airsoftak25/RoboCrew/README.md

# RoboCrew - Prosek

# Table of content
* NeoSumec
* LF-Neo - *doesnt exist yet*
* LF-Pendolino-MK1

# Description
This repo contains link to all other repo of ours projects  

# NeoSumec
An autonomous robot that competes in Mini-Sumo competitions, made by a team of students from **SPŠ-Prosek**.
| Part | Repo link | Description |
|:-:|:-:|:-|
| Software | [Open](https://github.com/kubikaugustyn/NeoSumec-MiniSumo-FW) | Contains our code for project |
| Hardware | [Open](https://github.com/airsoftak25/NeoSumec-MiniSumo-HW) | Contains our elektro stuff for project |
| Mechanical | [Open](https://github.com/airsoftak25/NeoSumec-MiniSumo-MECH) | Contains our mechanical part of project |

## Contributors
Peoples that work on the some part of our project **NeoSumec**
| Name | On what part they work |
|:-:|:-|
| Vadim Sobčuk (airsoftak25)| Head of HW and Mech part|
| Jakub Augustýn | Head of coding |

# LF-Neo
An autonomous robot designed to complete the track in the shortest possible time. Made by a team of students from **SPŠ-Prosek**.
**Doesnt exist  yet**
| Part | Repo link | Description |
|:-:|:-:|:-|
| Software | [Open](Doesnt-exist-yet) | Contains our code for project |
| Hardware | [Open](Doesnt-exist-yet) | Contains our elektro stuff for project |
| Mechanical | [Open](Doesnt-exist-yet) | Contains our mechanical part of project |

## Contributors
Peoples that work on the some part of our project **NeoSumec**
| Name | On what part they work |
|:-:|:-|
| Vadim Sobčuk | Who knows |

# Other project

## LF-Pendolino-MK1
An autonomus robot designed to complete the track in the shortest possible time. Maded by [**Luboš Stránský**](https://github.com/lubosstransky2008)
* [**Repo link**](https://github.com/lubosstransky2008/LF-Pendolino_MK1) *(this is his first solo project and we are proud of him)*
