airsoftak25/RoboCrew/RoboClash/LF-časomírá/HW/LF_LAP_TIMER.csv.xlsx

Reference | Qty | Value | Footprint | Link
A1 | 1 | Arduino_UNO_R3 | Module:Arduino_UNO_R3 | Link (https://dratek.cz/arduino-platforma/974-eses-klon-arduino-uno-r3-precise.html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)
C1 | 1 | 100nF | Capacitor_THT:C_Disc_D6.0mm_W2.5mm_P5.00mm
J1 | 1 | SENSOR TERMINAL | TerminalBlock:TerminalBlock_MaiXu_MX126-5.0-02P_1x02_P5.00mm | Link (https://www.gme.cz/v/1497255/kls-300-500-02p-2-sc-svorkovnice-2pol-roztec-5mm-16a-250v-vstup-90-sroub)
J2 | 1 | SENSOR TERMINAL | TerminalBlock:TerminalBlock_MaiXu_MX126-5.0-05P_1x05_P5.00mm | Link (https://www.gme.cz/v/1497255/kls-300-500-02p-2-sc-svorkovnice-2pol-roztec-5mm-16a-250v-vstup-90-sroub)
J3 | 1 | LCD TERMINAL | TerminalBlock:TerminalBlock_MaiXu_MX126-5.0-05P_1x05_P5.00mm | Link (https://dratek.cz/arduino-platforma/1570-iic-i2c-display-lcd-1602-16x2-znaku-lcd-modul-modry.html)
K1 | 1 | E3JK-5DM1-5L |  | Link (https://www.hadex.cz/p/t532-infracervena-zavora-e3jk-5dm1-5l-opticka-zavora-2)
R1,R2 | 2 | 0R | Resistor_THT:R_Axial_DIN0207_L6.3mm_D2.5mm_P10.16mm_Horizontal
R4,R5,R6,R9,R10 | 5 | 10K | Resistor_THT:R_Axial_DIN0207_L6.3mm_D2.5mm_P10.16mm_Horizontal
R7 | 1 | 1k | Resistor_THT:R_Axial_DIN0207_L6.3mm_D2.5mm_P10.16mm_Horizontal
R8 | 1 | 10k | Resistor_THT:R_Axial_DIN0207_L6.3mm_D2.5mm_P10.16mm_Horizontal
SW1 | 1 | ARM | TerminalBlock:TerminalBlock_MaiXu_MX126-5.0-02P_1x02_P5.00mm | Link (https://www.gme.cz/v/1498072/pbs-12b-g-tlacitko-do-panelu-1-pol-offon)
SW2 | 1 | STOP | TerminalBlock:TerminalBlock_MaiXu_MX126-5.0-02P_1x02_P5.00mm | Link (https://www.gme.cz/v/1497195/pbs-12b-r-tlacitko-do-panelu-1-pol-offon)
SW3 | 1 | RESTART | TerminalBlock:TerminalBlock_MaiXu_MX126-5.0-02P_1x02_P5.00mm | Link (https://www.gme.cz/v/1498070/pbs-12b-bl-tlacitko-do-panelu-1-pol-offon)
