airsoftak25/RoboCrew/RoboClash/LF-časomírá/MECH/LineFollower_Gate/Gate/Leg.dxf

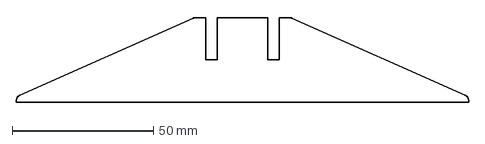
[picture p1: CAD file, 2026-03-25]
RoboClash/LF-časomírá/MECH/LineFollower_Gate/Gate/Leg.dxf
160.0 x 30.0 mm
