airsoftak25/RoboCrew/RoboClash/LF-časomírá/MECH/LineFollower_Gate/GateLessMaterial/GateBrigeSideLessMaterial.dxf

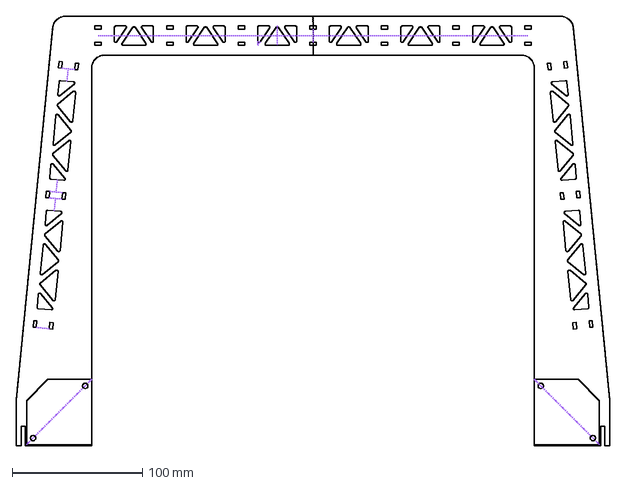
[picture p2: CAD file, 2026-04-06]
RoboClash/LF-časomírá/MECH/LineFollower_Gate/GateLessMaterial/GateBrigeSideLessMaterial.dxf
456.0 x 330.0 mm
