airsoftak25/RoboCrew/RoboClash/LF-časomírá/MECH/LineFollower_Gate/LF_Gate.dxf

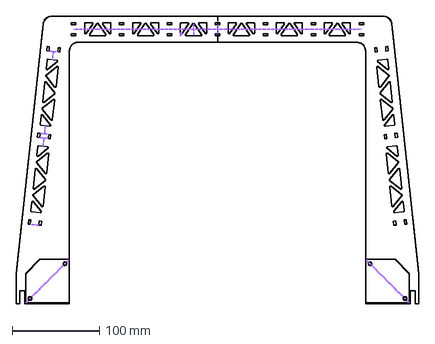
[picture p3: CAD file, 2026-04-11]
RoboClash/LF-časomírá/MECH/LineFollower_Gate/LF_Gate.dxf
462.0 x 330.0 mm
