airsoftak25/RoboCrew/RoboClash/LF-časomírá/MECH/LineFollower_Gate/Gate/Spacer.dxf

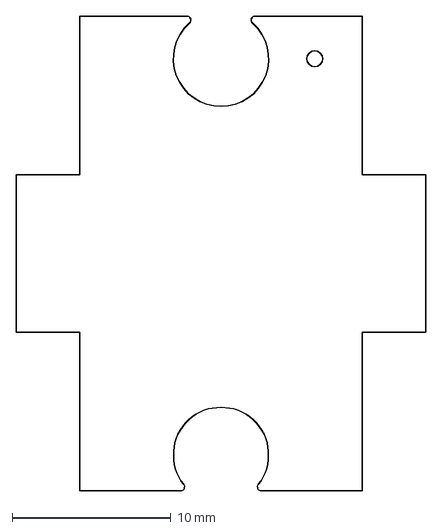
[picture p4: CAD file, 2026-03-25]
RoboClash/LF-časomírá/MECH/LineFollower_Gate/Gate/Spacer.dxf
25.8 x 29.9 mm
