airsoftak25/RoboCrew/RoboClash/LF-časomírá/MECH/LineFollower_Gate/GateLessMaterial/LegLessMaterial.dxf

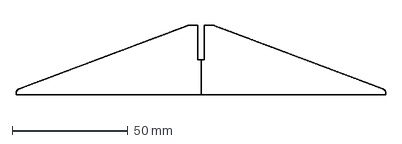
[picture p5: CAD file, 2026-04-06]
RoboClash/LF-časomírá/MECH/LineFollower_Gate/GateLessMaterial/LegLessMaterial.dxf
160.0 x 30.0 mm
