airsoftak25/RoboCrew/RoboClash/LF-časomírá/MECH/LineFollower_Gate/leg.dxf

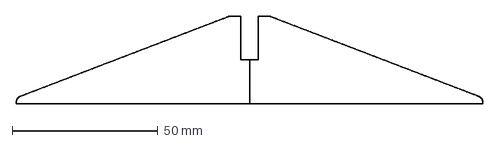
[picture p6: CAD file, 2026-04-11]
RoboClash/LF-časomírá/MECH/LineFollower_Gate/leg.dxf
160.0 x 30.0 mm
