airsoftak25/RoboCrew/RoboClash/LF-časomírá/MECH/LineFollower_Gate/Gate/GateBrigeSide.dxf

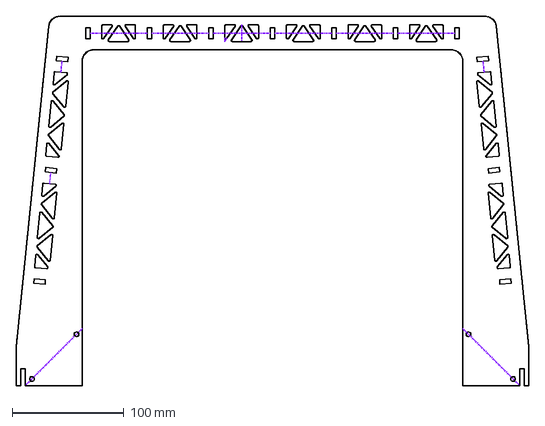
[picture p7: CAD file, 2026-03-25]
RoboClash/LF-časomírá/MECH/LineFollower_Gate/Gate/GateBrigeSide.dxf
458.0 x 330.0 mm
