airsoftak25/RoboCrew/RoboClash/LF-časomírá/MECH/_V1/LineFolloweLapTimer_PCB-Housing/FL-LapTimer-noha.stl

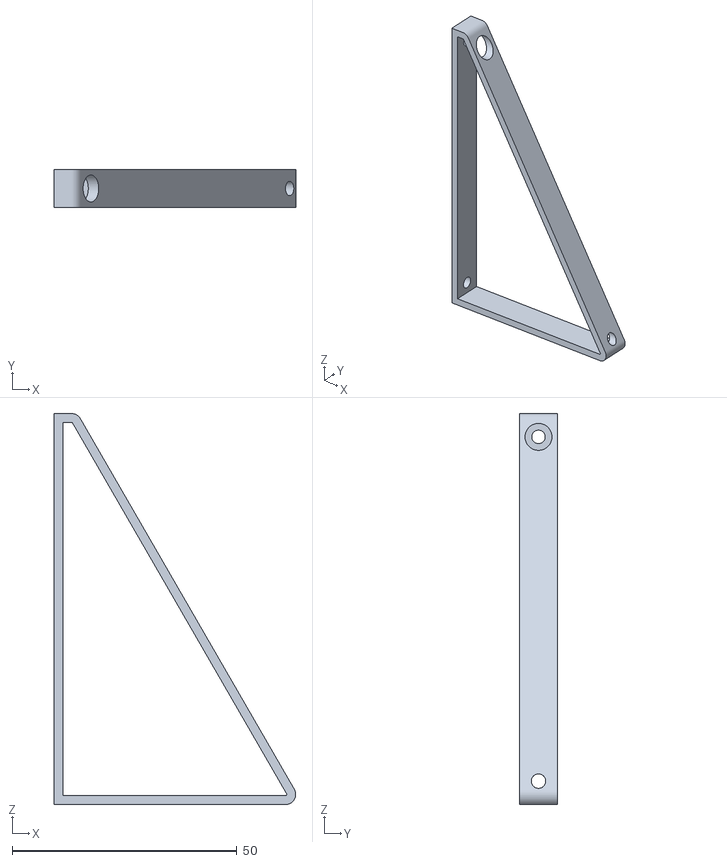
[picture p8: CAD file, 2026-03-25, an earlier design]
RoboClash/LF-časomírá/MECH/_V1/LineFolloweLapTimer_PCB-Housing/FL-LapTimer-noha.stl
53.7 x 8.50 x 87.0
