airsoftak25/RoboCrew/RoboClash/LF-časomírá/MECH/_V1/LineFolloweLapTimer_PCB-Housing/PCB-HousingTop.stl

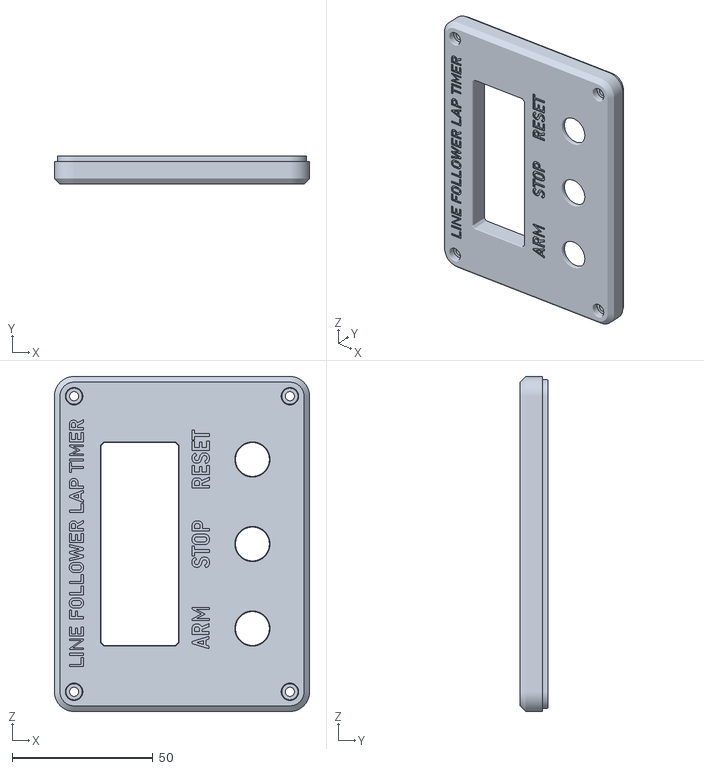
[picture p9: CAD file, 2026-03-25, an earlier design]
RoboClash/LF-časomírá/MECH/_V1/LineFolloweLapTimer_PCB-Housing/PCB-HousingTop.stl
90.6 x 10.0 x 118.9
