airsoftak25/RoboCrew/RoboClash/LF-časomírá/MECH/_V1/LineFolloweLapTimer_PCB-Housing/PCB-HousingBottom.stl

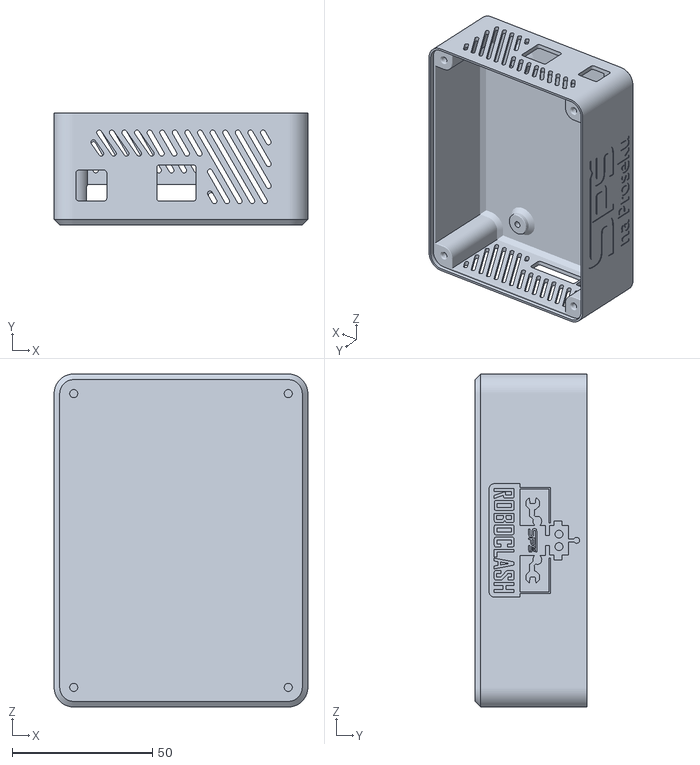
[picture p10: CAD file, 2026-03-25, an earlier design]
RoboClash/LF-časomírá/MECH/_V1/LineFolloweLapTimer_PCB-Housing/PCB-HousingBottom.stl
90.6 x 40.0 x 118.9
