airsoftak25/RoboCrew/(list of files, cad)

Other CAD files:
RoboClash/LF-časomírá/MECH/LineFollower_Gate/Gate/GateAssembly.iam
RoboClash/LF-časomírá/MECH/LineFollower_Gate/Gate/GateBrigeSide.ipt
RoboClash/LF-časomírá/MECH/LineFollower_Gate/Gate/Leg.ipt
RoboClash/LF-časomírá/MECH/LineFollower_Gate/Gate/OldVersions/GateAssembly.0001.iam
RoboClash/LF-časomírá/MECH/LineFollower_Gate/Gate/OldVersions/GateBrigeSide.0004.ipt
RoboClash/LF-časomírá/MECH/LineFollower_Gate/Gate/OldVersions/Spacer.0003.ipt
RoboClash/LF-časomírá/MECH/LineFollower_Gate/Gate/Sensor.ipt
RoboClash/LF-časomírá/MECH/LineFollower_Gate/Gate/Spacer.ipt
RoboClash/LF-časomírá/MECH/LineFollower_Gate/GateLessMaterial/GateBrigeSideLessMaterial.ipt
RoboClash/LF-časomírá/MECH/LineFollower_Gate/GateLessMaterial/GateLessMaterialAssembly.iam
RoboClash/LF-časomírá/MECH/LineFollower_Gate/GateLessMaterial/LegLessMaterial.ipt
RoboClash/LF-časomírá/MECH/LineFollower_Gate/GateLessMaterial/OldVersions/GateBrigeSide.0003.ipt
RoboClash/LF-časomírá/MECH/LineFollower_Gate/GateLessMaterial/OldVersions/GateLessMaterialAssembly.0001.iam
RoboClash/LF-časomírá/MECH/LineFollower_Gate/GateLessMaterial/OldVersions/Leg.0001.ipt
RoboClash/LF-časomírá/MECH/LineFollower_Gate/GateLessMaterial/Sensor.ipt
RoboClash/LF-časomírá/MECH/_V1/LineFolloweLapTimer_PCB-Housing/FL-LapTimer-Foot.ipt
RoboClash/LF-časomírá/MECH/_V1/LineFolloweLapTimer_PCB-Housing/LF_LAP_TIMER/10 PORT HEADER.ipt
RoboClash/LF-časomírá/MECH/_V1/LineFolloweLapTimer_PCB-Housing/LF_LAP_TIMER/102 RESISTOR PACK.ipt
RoboClash/LF-časomírá/MECH/_V1/LineFolloweLapTimer_PCB-Housing/LF_LAP_TIMER/103 RESISTOR PACK.ipt
RoboClash/LF-časomírá/MECH/_V1/LineFolloweLapTimer_PCB-Housing/LF_LAP_TIMER/16mhz crystal - measured.ipt
RoboClash/LF-časomírá/MECH/_V1/LineFolloweLapTimer_PCB-Housing/LF_LAP_TIMER/220 RESISTOR PACK.ipt
RoboClash/LF-časomírá/MECH/_V1/LineFolloweLapTimer_PCB-Housing/LF_LAP_TIMER/2pin_header__02.ipt
RoboClash/LF-časomírá/MECH/_V1/LineFolloweLapTimer_PCB-Housing/LF_LAP_TIMER/47uf CAP Dcase.ipt
RoboClash/LF-časomírá/MECH/_V1/LineFolloweLapTimer_PCB-Housing/LF_LAP_TIMER/6 PORT HEADER.ipt
RoboClash/LF-časomírá/MECH/_V1/LineFolloweLapTimer_PCB-Housing/LF_LAP_TIMER/603 cap on pad.ipt
RoboClash/LF-časomírá/MECH/_V1/LineFolloweLapTimer_PCB-Housing/LF_LAP_TIMER/603 resistor.ipt
RoboClash/LF-časomírá/MECH/_V1/LineFolloweLapTimer_PCB-Housing/LF_LAP_TIMER/8 PORT HEADER.ipt
RoboClash/LF-časomírá/MECH/_V1/LineFolloweLapTimer_PCB-Housing/LF_LAP_TIMER/ATMEL328P.ipt
RoboClash/LF-časomírá/MECH/_V1/LineFolloweLapTimer_PCB-Housing/LF_LAP_TIMER/C_Disc_D6.0mm_W2.5mm_P5.00mm.ipt
RoboClash/LF-časomírá/MECH/_V1/LineFolloweLapTimer_PCB-Housing/LF_LAP_TIMER/LCD.iam
RoboClash/LF-časomírá/MECH/_V1/LineFolloweLapTimer_PCB-Housing/LF_LAP_TIMER/LF_LAP_TIMER.iam
RoboClash/LF-časomírá/MECH/_V1/LineFolloweLapTimer_PCB-Housing/LF_LAP_TIMER/LF_LAP_TIMER_PCB.ipt
RoboClash/LF-časomírá/MECH/_V1/LineFolloweLapTimer_PCB-Housing/LF_LAP_TIMER/LF_LAP_TIMER_silkscreen.ipt
RoboClash/LF-časomírá/MECH/_V1/LineFolloweLapTimer_PCB-Housing/LF_LAP_TIMER/MLC0603.ipt
RoboClash/LF-časomírá/MECH/_V1/LineFolloweLapTimer_PCB-Housing/LF_LAP_TIMER/PADS001.ipt
RoboClash/LF-časomírá/MECH/_V1/LineFolloweLapTimer_PCB-Housing/LF_LAP_TIMER/PCB-HousingBottom.ipt
RoboClash/LF-časomírá/MECH/_V1/LineFolloweLapTimer_PCB-Housing/LF_LAP_TIMER/PCB-HousingTop.ipt
RoboClash/LF-časomírá/MECH/_V1/LineFolloweLapTimer_PCB-Housing/LF_LAP_TIMER/RESET BUTTON.iam
RoboClash/LF-časomírá/MECH/_V1/LineFolloweLapTimer_PCB-Housing/LF_LAP_TIMER/RESET CORE.ipt
RoboClash/LF-časomírá/MECH/_V1/LineFolloweLapTimer_PCB-Housing/LF_LAP_TIMER/RESET.ipt
RoboClash/LF-časomírá/MECH/_V1/LineFolloweLapTimer_PCB-Housing/LF_LAP_TIMER/R_Axial_DIN0207_L6.3mm_D2.5mm_P10.16mm_Horizontal.ipt
RoboClash/LF-časomírá/MECH/_V1/LineFolloweLapTimer_PCB-Housing/LF_LAP_TIMER/USB SHELL.ipt
RoboClash/LF-časomírá/MECH/_V1/LineFolloweLapTimer_PCB-Housing/LF_LAP_TIMER/USB core.ipt
RoboClash/LF-časomírá/MECH/_V1/LineFolloweLapTimer_PCB-Housing/LF_LAP_TIMER/USB type b.SLDPRT.iam
RoboClash/LF-časomírá/MECH/_V1/LineFolloweLapTimer_PCB-Housing/LF_LAP_TIMER/_PCB-HousingAssembly.iam
RoboClash/LF-časomírá/MECH/_V1/LineFolloweLapTimer_PCB-Housing/LF_LAP_TIMER/arduino uno.iam
RoboClash/LF-časomírá/MECH/_V1/LineFolloweLapTimer_PCB-Housing/LF_LAP_TIMER/atmega16u2.ipt
RoboClash/LF-časomírá/MECH/_V1/LineFolloweLapTimer_PCB-Housing/LF_LAP_TIMER/blm21.ipt
RoboClash/LF-časomírá/MECH/_V1/LineFolloweLapTimer_PCB-Housing/LF_LAP_TIMER/cd1206 diode.ipt
RoboClash/LF-časomírá/MECH/_V1/LineFolloweLapTimer_PCB-Housing/LF_LAP_TIMER/crystal.ipt
RoboClash/LF-časomírá/MECH/_V1/LineFolloweLapTimer_PCB-Housing/LF_LAP_TIMER/dip socket pin.ipt
RoboClash/LF-časomírá/MECH/_V1/LineFolloweLapTimer_PCB-Housing/LF_LAP_TIMER/dip28.iam
RoboClash/LF-časomírá/MECH/_V1/LineFolloweLapTimer_PCB-Housing/LF_LAP_TIMER/dip28.ipt
RoboClash/LF-časomírá/MECH/_V1/LineFolloweLapTimer_PCB-Housing/LF_LAP_TIMER/led.ipt
RoboClash/LF-časomírá/MECH/_V1/LineFolloweLapTimer_PCB-Housing/LF_LAP_TIMER/lmv358.ipt
RoboClash/LF-časomírá/MECH/_V1/LineFolloweLapTimer_PCB-Housing/LF_LAP_TIMER/lp2985dgkr.ipt
RoboClash/LF-časomírá/MECH/_V1/LineFolloweLapTimer_PCB-Housing/LF_LAP_TIMER/m7 diode.ipt
RoboClash/LF-časomírá/MECH/_V1/LineFolloweLapTimer_PCB-Housing/LF_LAP_TIMER/mf-msmf050-2.ipt
RoboClash/LF-časomírá/MECH/_V1/LineFolloweLapTimer_PCB-Housing/LF_LAP_TIMER/nano - reg.ipt
RoboClash/LF-časomírá/MECH/_V1/LineFolloweLapTimer_PCB-Housing/LF_LAP_TIMER/power jack.ipt
RoboClash/LF-časomírá/MECH/_V1/LineFolloweLapTimer_PCB-Housing/LF_LAP_TIMER/ssot3.ipt
RoboClash/LF-časomírá/MECH/_V1/LineFolloweLapTimer_PCB-Housing/LF_LAP_TIMER/unoboard blue.ipt
RoboClash/LF-časomírá/MECH/_V1/LineFolloweLapTimer_PCB-Housing/LF_LAP_TIMER/usb btm contact.ipt
RoboClash/LF-časomírá/MECH/_V1/LineFolloweLapTimer_PCB-Housing/LF_LAP_TIMER/usb top contact.ipt
RoboClash/LF-časomírá/MECH/_V1/LineFolloweLapTimer_PCB-Housing/OldVersions/LF_LAP_TIMER.0001.iam
RoboClash/LF-časomírá/MECH/_V1/LineFolloweLapTimer_PCB-Housing/OldVersions/PCB-HousingAssembly.0005.iam
RoboClash/LF-časomírá/MECH/_V1/LineFolloweLapTimer_PCB-Housing/OldVersions/PCB-HousingBottom.0011.ipt
RoboClash/LF-časomírá/MECH/_V1/LineFolloweLapTimer_PCB-Housing/OldVersions/PCB-HousingTop.0009.ipt
RoboClash/LF-časomírá/MECH/_V2/Comp/180690550-9-1729128/1729128.iam
RoboClash/LF-časomírá/MECH/_V2/Comp/180690550-9-1729128/1729128_01.ipt
RoboClash/LF-časomírá/MECH/_V2/Comp/180690550-9-1729128/1729128_02.ipt
RoboClash/LF-časomírá/MECH/_V2/Comp/180690550-9-1729128/1729128_03.ipt
RoboClash/LF-časomírá/MECH/_V2/Comp/180690550-9-1729128/1729128_04.ipt
RoboClash/LF-časomírá/MECH/_V2/Comp/180690550-9-1729128/1729128_05.ipt
RoboClash/LF-časomírá/MECH/_V2/Comp/180690550-9-1729128/1729128_06.ipt
RoboClash/LF-časomírá/MECH/_V2/Comp/180690550-9-1729128/1729128_07.ipt
RoboClash/LF-časomírá/MECH/_V2/Comp/180690877-9-1729131/1729131.iam
RoboClash/LF-časomírá/MECH/_V2/Comp/180690877-9-1729131/1729131_01.ipt
RoboClash/LF-časomírá/MECH/_V2/Comp/180690877-9-1729131/1729131_02.ipt
RoboClash/LF-časomírá/MECH/_V2/Comp/180690877-9-1729131/1729131_03.ipt
RoboClash/LF-časomírá/MECH/_V2/Comp/180690877-9-1729131/1729131_04.ipt
RoboClash/LF-časomírá/MECH/_V2/Comp/180690877-9-1729131/1729131_05.ipt
RoboClash/LF-časomírá/MECH/_V2/Comp/180690877-9-1729131/1729131_06.ipt
RoboClash/LF-časomírá/MECH/_V2/Comp/180690877-9-1729131/1729131_07.ipt
RoboClash/LF-časomírá/MECH/_V2/Comp/180690877-9-1729131/1729131_08.ipt
RoboClash/LF-časomírá/MECH/_V2/Comp/180690877-9-1729131/1729131_09.ipt
RoboClash/LF-časomírá/MECH/_V2/Comp/180690877-9-1729131/1729131_10.ipt
RoboClash/LF-časomírá/MECH/_V2/Comp/2pin_header__02.ipt
RoboClash/LF-časomírá/MECH/_V2/Comp/LCD.iam
RoboClash/LF-časomírá/MECH/_V2/Comp/LF_LAP_TIMER_PCB.ipt
RoboClash/LF-časomírá/MECH/_V2/Comp/LF_LAP_TIMER_silkscreen.ipt
RoboClash/LF-časomírá/MECH/_V2/Comp/arduino uno.iam
RoboClash/LF-časomírá/MECH/_V2/FL-LapTimer/LF_LapTimer-Bottom.ipt
RoboClash/LF-časomírá/MECH/_V2/FL-LapTimer/LF_LapTimer-PCB.iam
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
