airsoftak25/RoboCrew/RoboClash/LF-časomírá/HW/LF_LAP_TIMER.kicad_pcb

## KiCad design RoboClash/LF-časomírá/HW/LF_LAP_TIMER.kicad_pcb (2026-03-26)

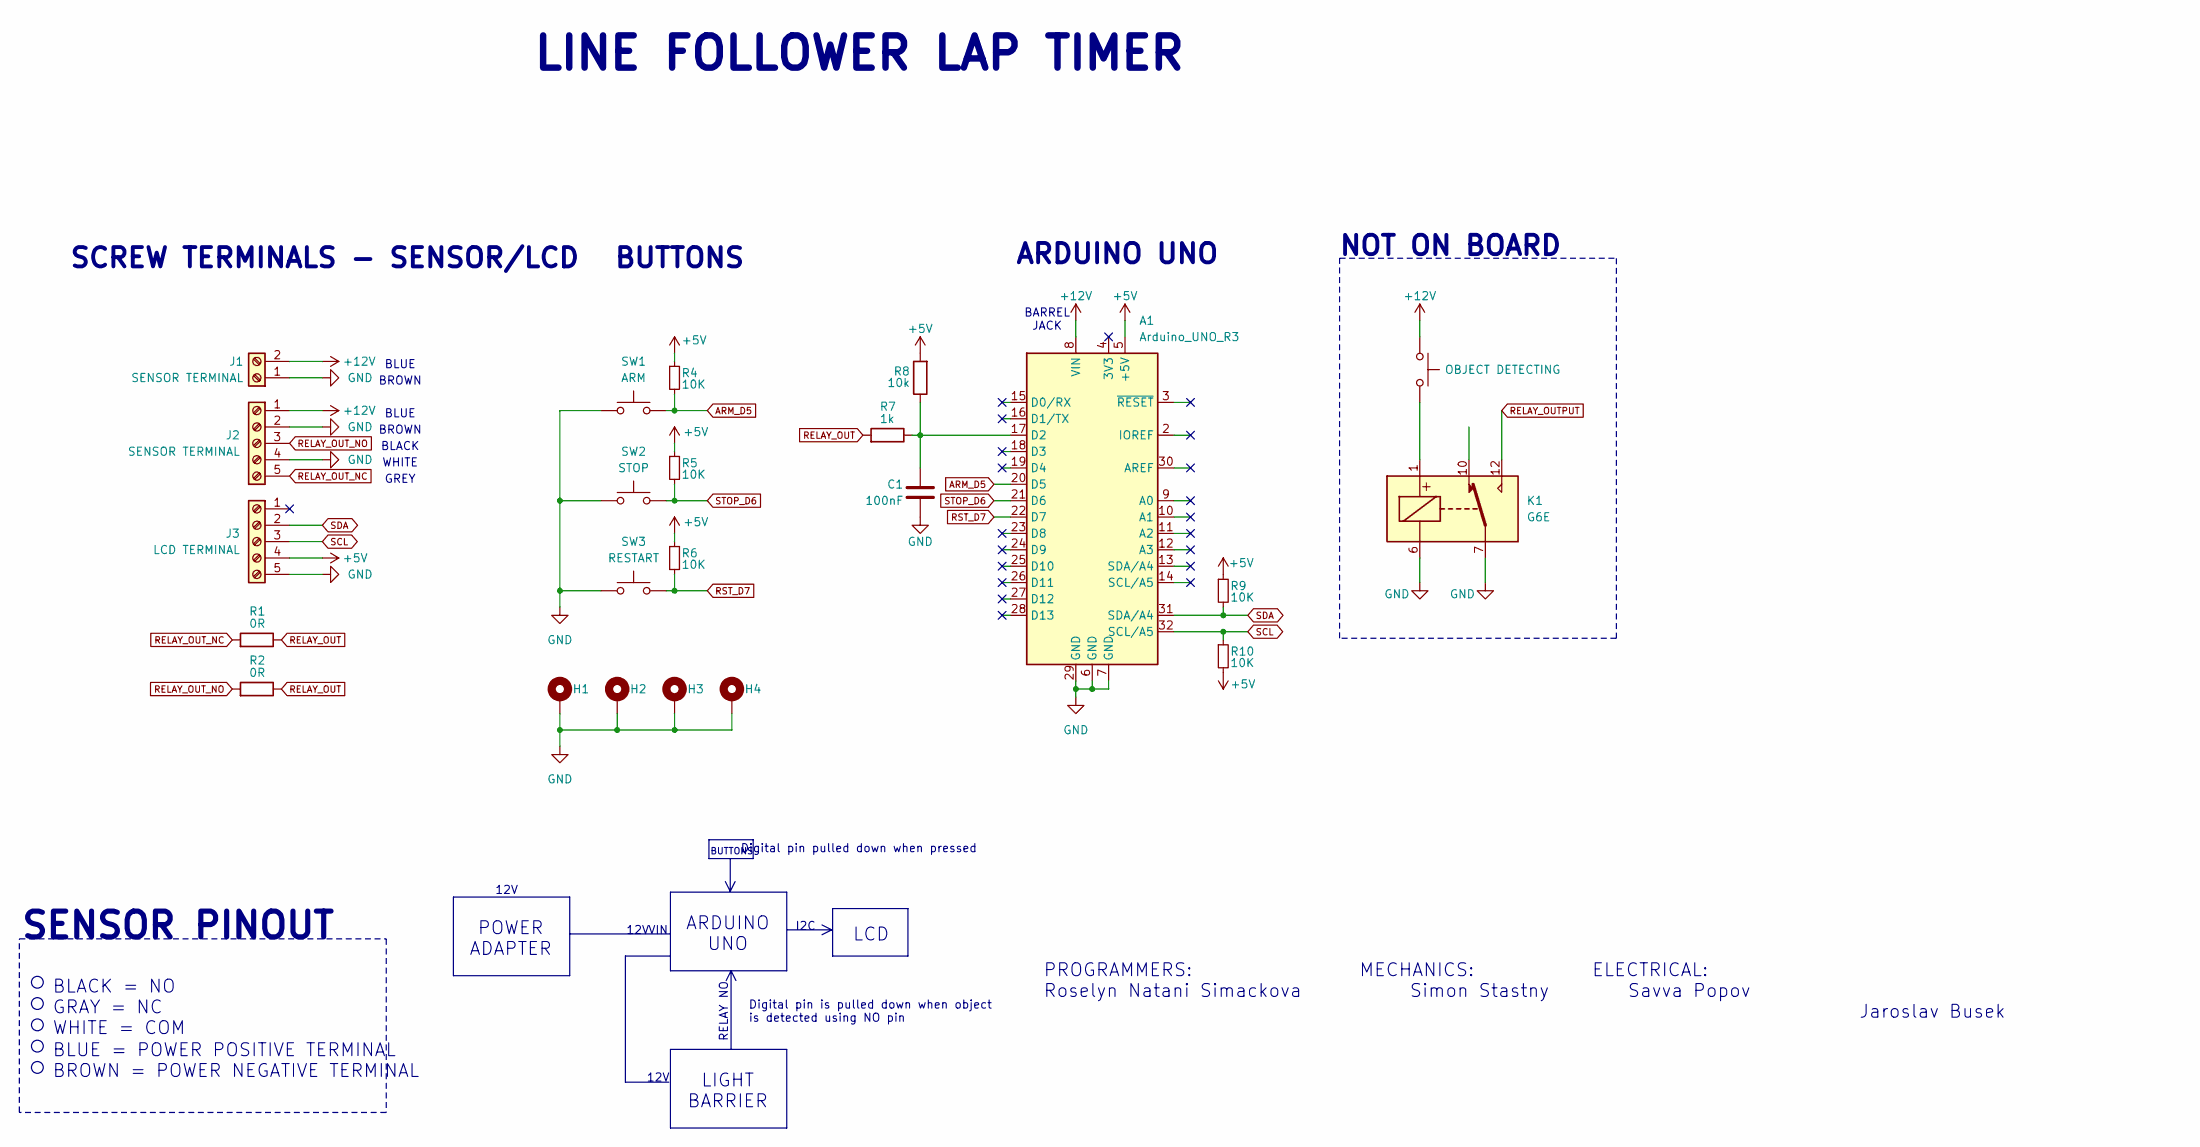
[picture p11: schematic LF_LAP_TIMER.kicad_sch]

Parts:
A1: Arduino_UNO_R3
C1: 100nF; C_Disc_D6.0mm_W2.5mm_P5.00mm
H1, H2, H3, H4: MountingHole_Pad; MountingHole_3.2mm_M3_Pad
J1: SENSOR TERMINAL; TerminalBlock_MaiXu_MX126-5.0-02P_1x02_P5.00mm
J2: SENSOR TERMINAL; TerminalBlock_MaiXu_MX126-5.0-05P_1x05_P5.00mm
J3: LCD TERMINAL; TerminalBlock_MaiXu_MX126-5.0-05P_1x05_P5.00mm
K1: G6E
R1, R2: 0R; R_Axial_DIN0207_L6.3mm_D2.5mm_P10.16mm_Horizontal
R4, R5, R6, R9, R10: 10K; R_Axial_DIN0207_L6.3mm_D2.5mm_P10.16mm_Horizontal
R7: 1k; R_Axial_DIN0207_L6.3mm_D2.5mm_P10.16mm_Horizontal
R8: 10k; R_Axial_DIN0207_L6.3mm_D2.5mm_P10.16mm_Horizontal
SW1: ARM; TerminalBlock_MaiXu_MX126-5.0-02P_1x02_P5.00mm
SW2: STOP; TerminalBlock_MaiXu_MX126-5.0-02P_1x02_P5.00mm
SW3: RESTART; TerminalBlock_MaiXu_MX126-5.0-02P_1x02_P5.00mm
SW4: OBJECT DETECTING

Connections:
+5V: A1.5 (+5V), J3.4, R4.1, R5.1, R6.1, R8.2, R9.1, R10.2
+12V: A1.8 (VIN), J1.2, J2.1, SW4.1
ARM_D5: A1.20 (D5), R4.2, SW1.2
GND: A1.6 (GND), A1.7 (GND), A1.29 (GND), C1.2, H1.1, H2.1, H3.1, H4.1, J1.1, J2.2, J2.4, J3.5, K1.6, K1.7, SW1.1, SW2.1, SW3.1
unnamed: A1.17 (D2), C1.1, R7.1, R8.1
unnamed: K1.1, SW4.2
RELAY_OUT: R1.1, R2.1, R7.2
RELAY_OUT_NC: J2.5, R1.2
RELAY_OUT_NO: J2.3, R2.2
RST_D7: A1.22 (D7), R6.2, SW3.2
SCL: A1.32 (SCL/A5), J3.3, R10.1
SDA: A1.31 (SDA/A4), J3.2, R9.2
STOP_D6: A1.21 (D6), R5.2, SW2.2

Notes on the sheet:
BLUE = POWER POSITIVE TERMINAL BROWN = POWER NEGATIVE TERMINAL
ARDUINO UNO
BROWN
BUTTONS
12V
SCREW TERMINALS - SENSOR/LCD
VIN
I2C
SENSOR PINOUT
BARREL JACK
RELAY NO
BLUE
WHITE
LIGHT BARRIER
BLACK
GREY
ARDUINO UNO
LINE FOLLOWER LAP TIMER
LCD
BLACK = NO GRAY = NC WHITE = COM
POWER ADAPTER
NOT ON BOARD
Digital pin pulled down when pressed
PROGRAMMERS: MECHANICS: ELECTRICAL: Roselyn Natani Simackova Simon Stastny Savva Popov Jaroslav Busek
Digital pin is pulled down when object is detected using NO pin

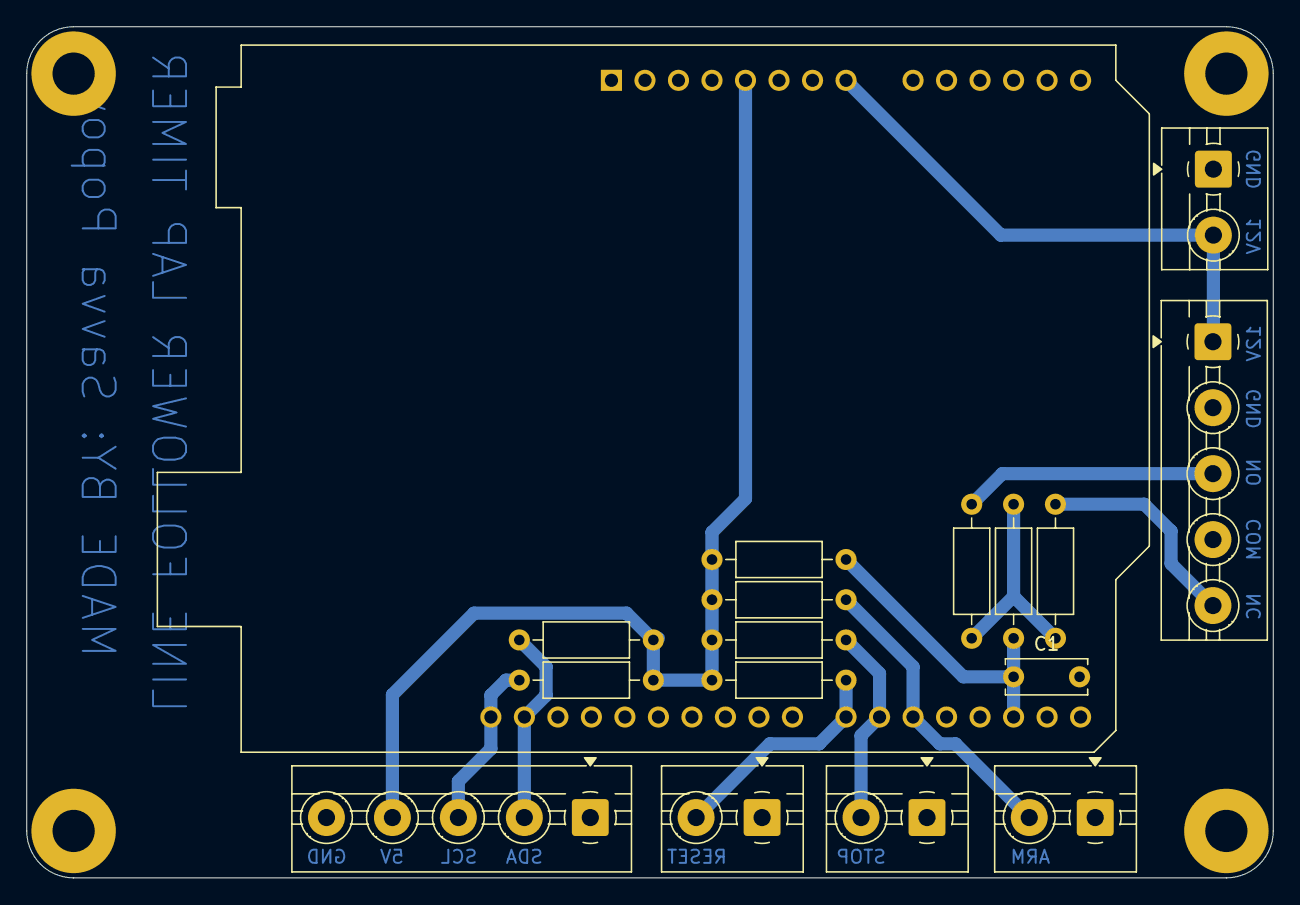
[picture p12: board LF_LAP_TIMER.kicad_pcb from above]

Board: 2 copper layers, 94.5 x 64.5 mm, 21 parts (0 on the bottom side), 12 nets.
