airsoftak25/RoboCrew/(commit log)

2026-03-25 add RoboClash stuff
    [10 PORT HEADER.ipt, 102 RESISTOR PACK.ipt, 103 RESISTOR PACK.ipt, 16mhz crystal - measured.ipt, 1729128.iam, 1729128_01.ipt, 1729128_02.ipt, 1729128_03.ipt]
2026-03-25 roboclash - foot
    [FL-LapTimer-Foot.ipt, FL-LapTimer-noha.stl]
2026-03-26 Added HW and SW files to lap timer
    [10 PORT HEADER.ipt, 102 RESISTOR PACK.ipt, 103 RESISTOR PACK.ipt, 16mhz crystal - measured.ipt, 1729128.iam, 1729128_01.ipt, 1729128_02.ipt, 1729128_03.ipt]
2026-03-26 addet smthing
    [FL-LapTimer-Foot.ipt, FL-LapTimer-noha.stl]
2026-03-27 Added exel for LapTimer
    [LF_LAP_TIMER.csv.xlsx, LF_LAP_TIMER.kicad_sch]
2026-04-06 swome upgrades
    [GateBrigeSideLessMaterial.0005.ipt, GateBrigeSideLessMaterial.dxf, GateBrigeSideLessMaterial.ipt, LF_Gate.dxf, LegLessMaterial.0002.ipt, LegLessMaterial.dxf, LegLessMaterial.ipt]
